concretedog/OBT_Open_Boat_Tail_Rocket/STLs/boattail_motor_block.stl

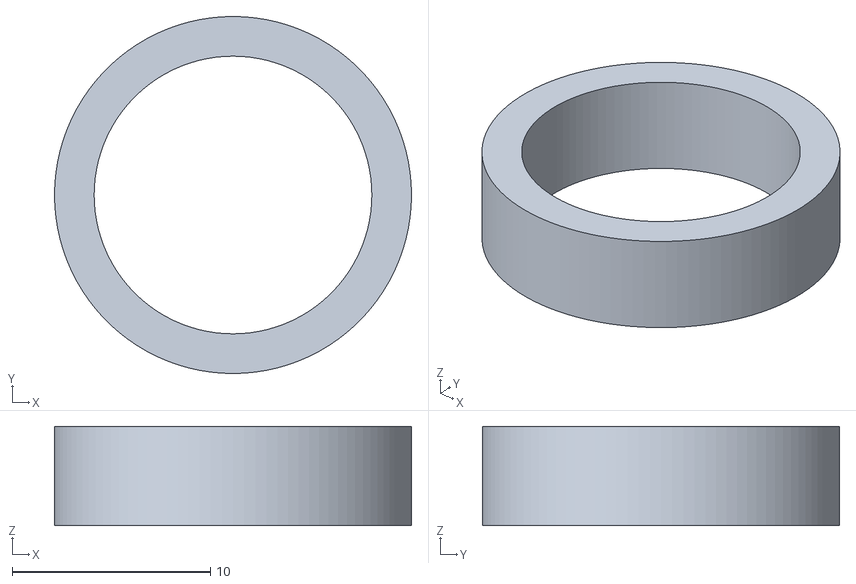
[picture p3: CAD file, 2018-06-04]
STLs/boattail_motor_block.stl
18.0 x 18.0 x 5.00
