concretedog/OBT_Open_Boat_Tail_Rocket/STLs/boattailMKIII.stl

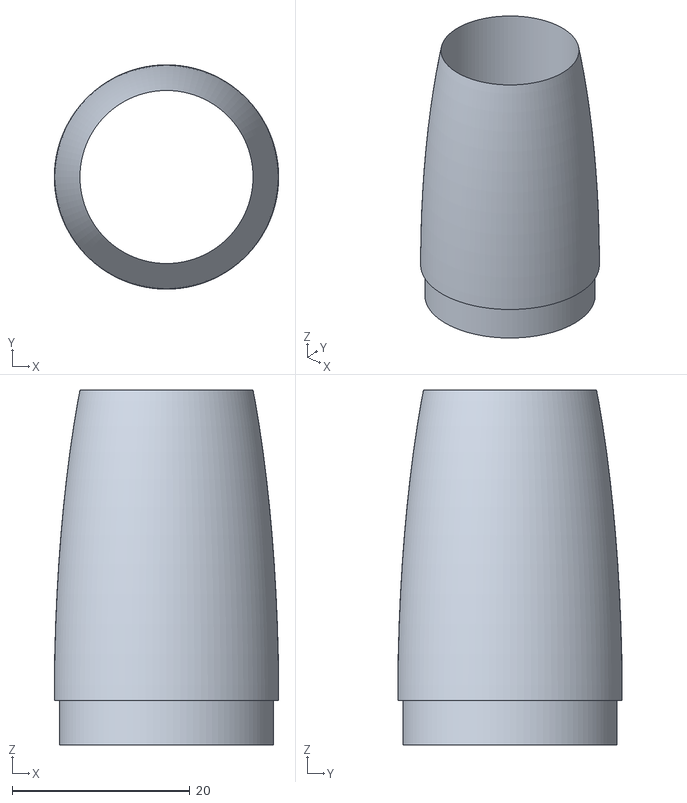
[picture p4: CAD file, 2018-06-04]
STLs/boattailMKIII.stl
25.3 x 25.3 x 40.0
