concretedog/OBT_Open_Boat_Tail_Rocket/STLs/boattail_ebaybase.stl

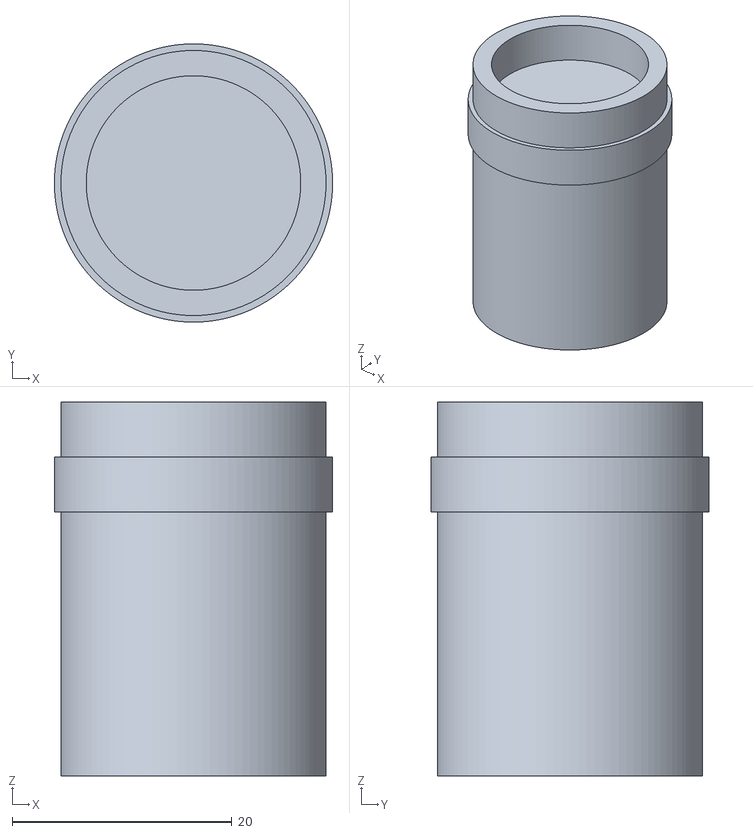
[picture p5: CAD file, 2018-06-04]
STLs/boattail_ebaybase.stl
25.3 x 25.3 x 34.0
