concretedog/OBT_Open_Boat_Tail_Rocket/STLs/boattail_NC_5mm.stl

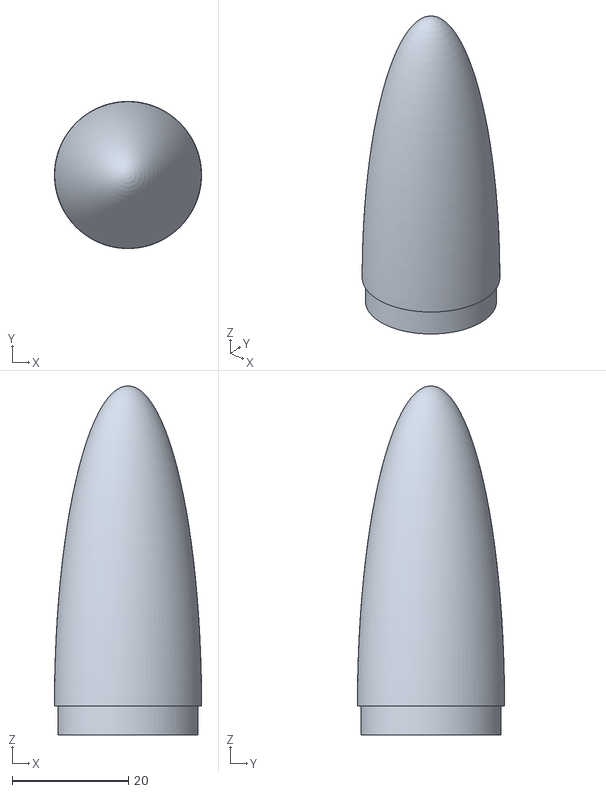
[picture p6: CAD file, 2018-06-04]
STLs/boattail_NC_5mm.stl
25.3 x 25.3 x 60.0
