concretedog/OBT_Open_Boat_Tail_Rocket/STLs/boattail_centeringring.stl

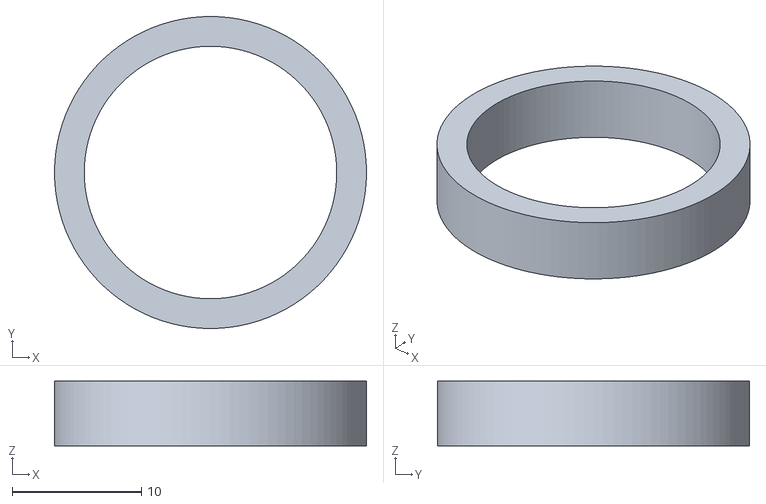
[picture p7: CAD file, 2018-06-04]
STLs/boattail_centeringring.stl
24.1 x 24.1 x 5.00
