concretedog/OBT_Open_Boat_Tail_Rocket/(list of files, cad)

Other CAD files:
OpenSCAD_files/boattail_centeringring.scad
OpenSCAD_files/boattail_ebaybase.scad
OpenSCAD_files/boattail_NC.scad
OpenSCAD_files/boattailMKIII.scad
